albertdolata/Sensitive-Parameter-Recorder/PCB/SensorModule/SensorModule.kicad_pcb

## KiCad design PCB/SensorModule/SensorModule.kicad_pcb (2026-05-22)

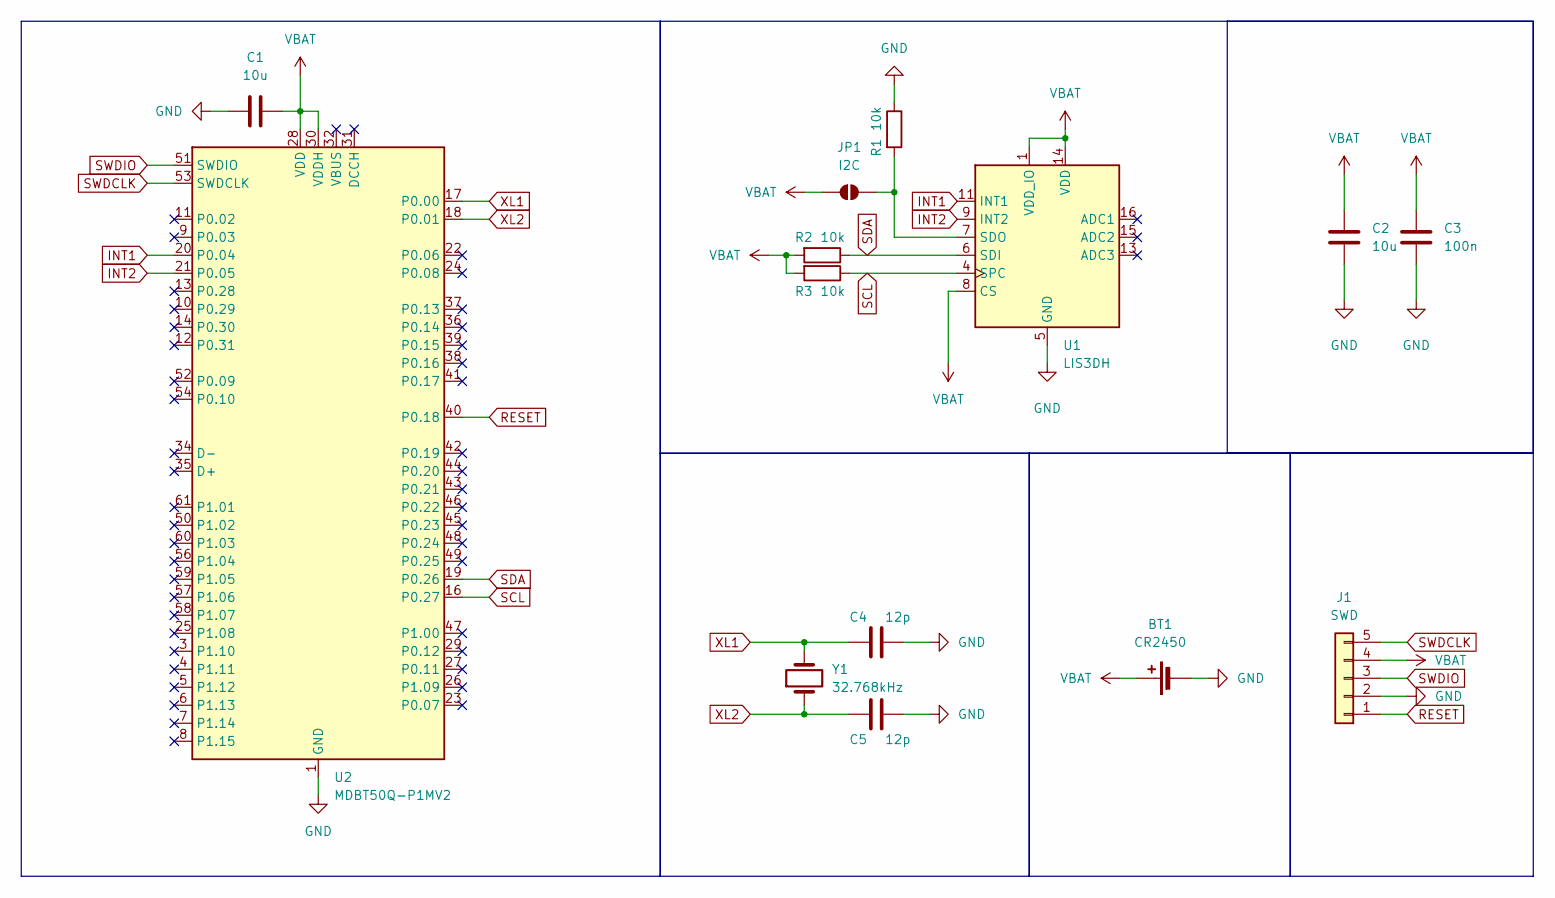
[picture p1: schematic SensorModule.kicad_sch, Sensor Module]

Parts:
BT1: CR2450; BatteryHolder_ComfortableElectronic_CH273-2450_1x2450
C1, C2: 10u; C_0402_1005Metric
C3: 100n; C_0402_1005Metric
C4, C5: 12p; C_0402_1005Metric
J1: SWD; PinHeader_1x05_P1.00mm_Vertical_SMD_Pin1Right
JP1: I2C; SolderJumper-2_P1.3mm_Open_TrianglePad1.0x1.5mm
R1, R2, R3: 10k; R_0402_1005Metric
U1: LIS3DH; LGA-16_3x3mm_P0.5mm_LayoutBorder3x5y
U2: MDBT50Q-P1MV2; Raytac_MDBT50Q
Y1: 32.768kHz; Crystal_SMD_3215-2Pin_3.2x1.5mm

Connections:
GND: BT1.2 (-), C1.1, C2.2, C3.2, C4.2, C5.2, J1.2, R1.1, U1.5 (GND), U1.10 (GND), U1.12 (GND), U2.1 (GND), U2.2 (GND), U2.15 (GND), U2.33 (GND), U2.55 (GND)
INT1: U1.11 (INT1), U2.20 (P0.04)
INT2: U1.9 (INT2), U2.21 (P0.05)
unnamed: JP1.1 (A), R1.2, U1.7 (SDO)
RESET: J1.1, U2.40 (P0.18)
SCL: R3.1, U1.4 (SPC), U2.16 (P0.27)
SDA: R2.1, U1.6 (SDI), U2.19 (P0.26)
SWDCLK: J1.5, U2.53 (SWDCLK)
SWDIO: J1.3, U2.51 (SWDIO)
VBAT: BT1.1 (+), C1.2, C2.1, C3.1, J1.4, JP1.2 (B), R2.2, R3.2, U1.1 (VDD_IO), U1.8 (CS), U1.14 (VDD), U2.28 (VDD), U2.30 (VDDH)
XL1: C4.1, U2.17 (P0.00), Y1.2
XL2: C5.1, U2.18 (P0.01), Y1.1

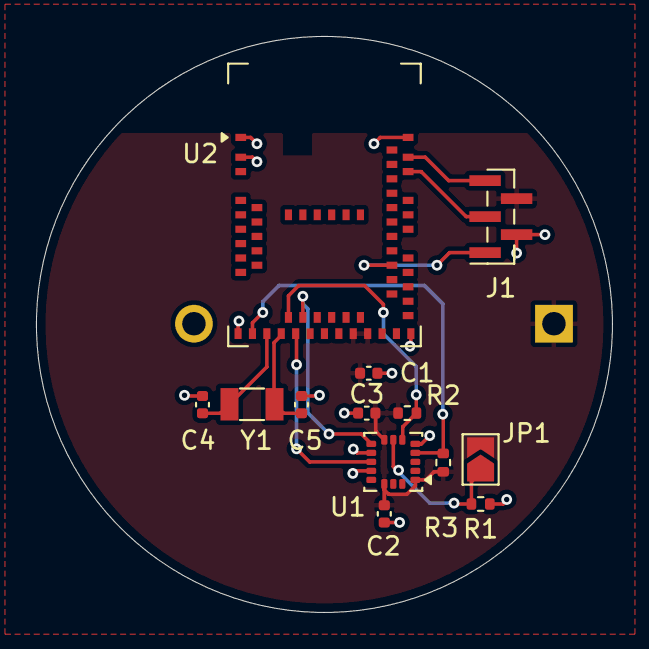
[picture p2: board SensorModule.kicad_pcb from above]

Board: 2 copper layers, 32.0 x 32.0 mm, 14 parts (1 on the bottom side), 12 nets.
