albertdolata/Sensitive-Parameter-Recorder/PCB/CentralUnit/CentralUnit.kicad_pcb

## KiCad design PCB/CentralUnit/CentralUnit.kicad_pcb (2026-05-22)

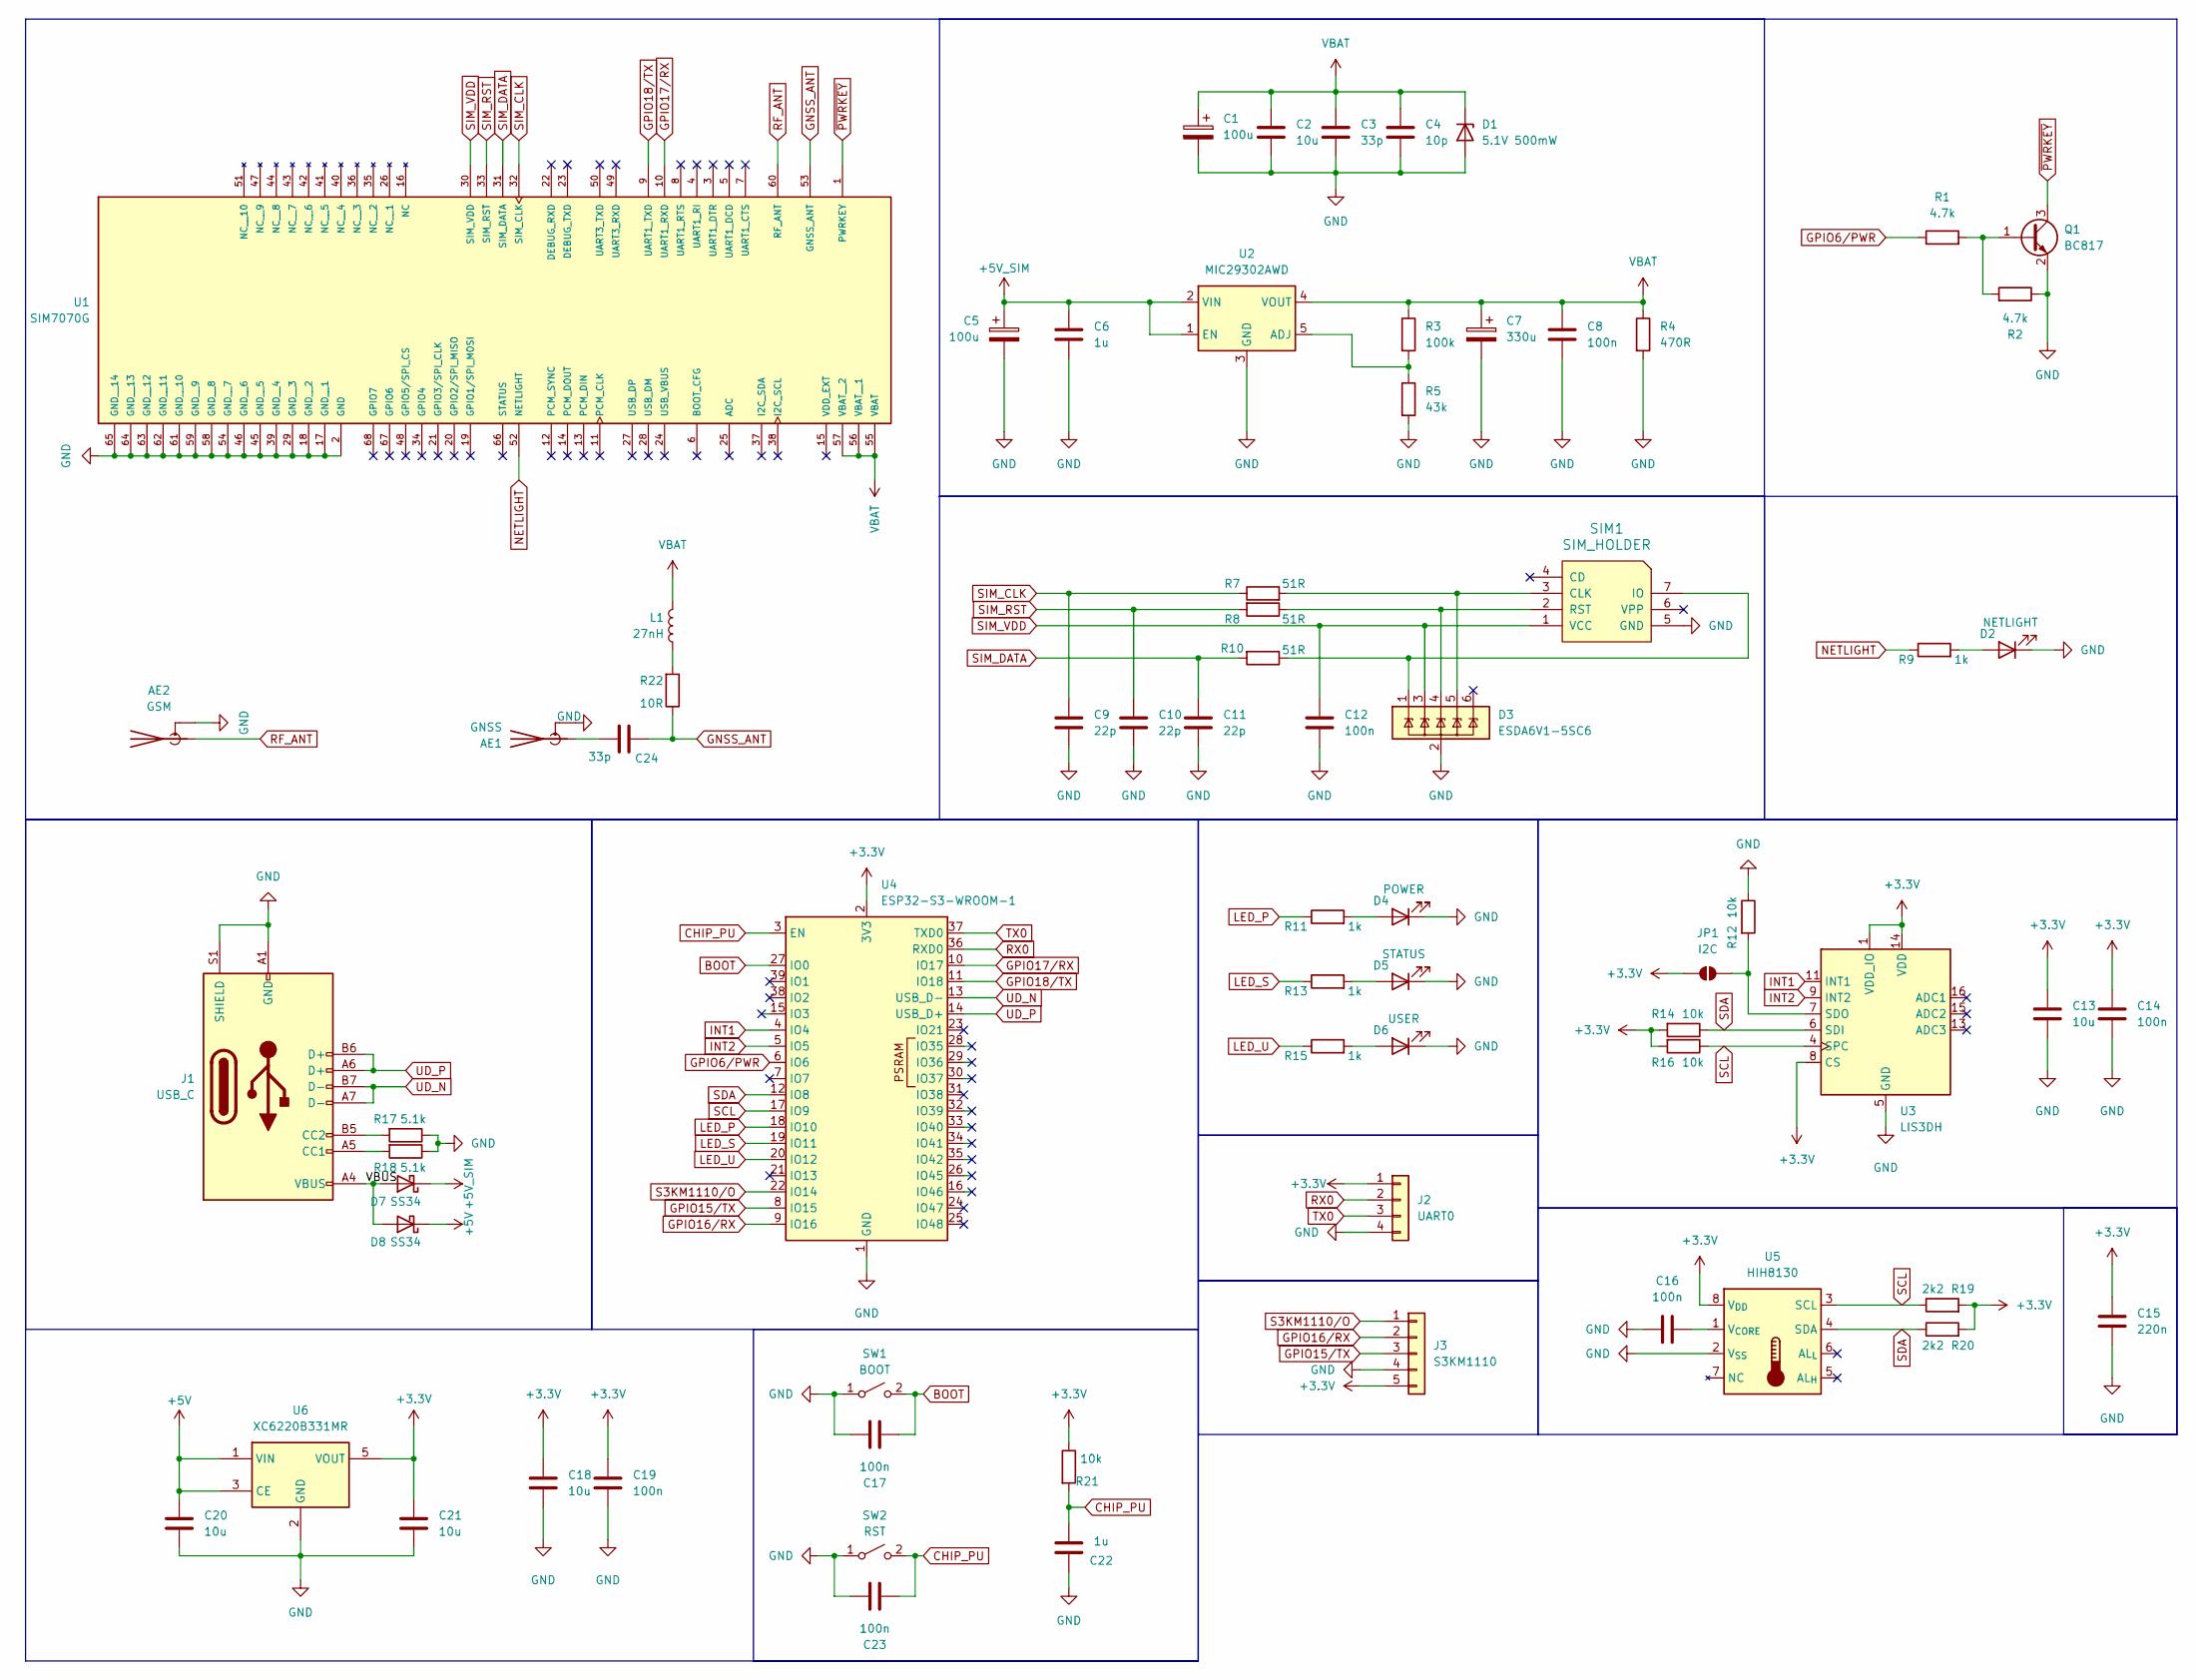
[picture p3: schematic CentralUnit.kicad_sch, Central Unit]

Parts:
AE1: GNSS; U.FL_Molex_MCRF_73412-0110_Vertical
AE2: GSM; U.FL_Molex_MCRF_73412-0110_Vertical
C1, C5: 100u; CP_EIA-3216-18_Kemet-A
C2, C13, C18, C20, C21: 10u; C_0402_1005Metric
C3, C24: 33p; C_0402_1005Metric
C4: 10p; C_0402_1005Metric
C6, C22: 1u; C_0402_1005Metric
C7: 330u; CP_EIA-6032-28_Kemet-C
C8, C12, C14, C16, C17, C19, C23: 100n; C_0402_1005Metric
C9, C10, C11: 22p; C_0402_1005Metric
C15: 220n; C_0402_1005Metric
D1: 5.1V 500mW; Nexperia_CFP3_SOD-123W
D2: NETLIGHT; LED_0805_2012Metric
D3: ESDA6V1-5SC6; SOT-23-6
D4: POWER; LED_0805_2012Metric
D5: STATUS; LED_0805_2012Metric
D6: USER; LED_0805_2012Metric
D7, D8: SS34; D_SMA
J1: USB_C; USB_C_Receptacle_HRO_TYPE-C-31-M-12
J2: UART0; PinHeader_1x04_P1.00mm_Vertical_SMD_Pin1Left
J3: S3KM1110; PinHeader_1x05_P2.54mm_Vertical
JP1: I2C; SolderJumper-2_P1.3mm_Open_TrianglePad1.0x1.5mm
L1: 27nH; L_0402_1005Metric
Q1: BC817; SOT-23
R1, R2: 4.7k; R_0402_1005Metric
R3: 100k; R_0402_1005Metric
R4: 470R; R_0402_1005Metric
R5: 43k; R_0402_1005Metric
R7, R8, R10: 51R; R_0402_1005Metric
R9, R11, R13, R15: 1k; R_0402_1005Metric; PART FIELD 1 ÌùÆ¬µç×è
R12, R14, R16, R21: 10k; R_0402_1005Metric
R17, R18: 5.1k; R_0402_1005Metric
R19, R20: 2k2; R_0402_1005Metric
R22: 10R; R_0402_1005Metric
SIM1: SIM_HOLDER; nanoSIM_SMN-303
SW1: BOOT; SW_Tactile_SPST_NO_Straight_CK_PTS636Sx25SMTRLFS
SW2: RST; SW_Tactile_SPST_NO_Straight_CK_PTS636Sx25SMTRLFS
U1: SIM7070G; SIM7070G_MODULE_SIM7070G; PARTREV V1.03
U2: MIC29302AWD; TO-252-5_1.27mm_TabPin3
U3: LIS3DH; LGA-16_3x3mm_P0.5mm_LayoutBorder3x5y
U4: ESP32-S3-WROOM-1
U5: HIH8130; SOIC-8_3.9x4.9mm_P1.27mm
U6: XC6220B331MR; SOT-23-5

Connections:
+3.3V: C13.1, C14.1, C15.1, C18.1, C19.1, C21.1, J2.1, J3.5, JP1.2 (B), R14.2, R16.2, R19.2, R20.2, R21.1, U3.1 (VDD_IO), U3.8 (CS), U3.14 (VDD), U4.2 (3V3), U5.8 (V_{DD}), U6.5 (VOUT)
+5V: C20.1, D8.1 (K), U6.1 (VIN), U6.3 (CE)
+5V_SIM: C5.1, C6.1, D7.1 (K), U2.1 (EN), U2.2 (VIN)
/VBUS: D7.2 (A), D8.2 (A), J1.A4 (VBUS), J1.A9 (VBUS), J1.B4 (VBUS), J1.B9 (VBUS)
BOOT: C17.2, SW1.2 (B), U4.27 (IO0)
CHIP_PU: C22.2, C23.2, R21.2, SW2.2 (B), U4.3 (EN)
GND: AE1.2 (Shield), AE2.2 (Shield), C1.2, C2.2, C3.2, C4.2, C5.2, C6.2, C7.2, C8.2, C9.2, C10.2, C11.2, C12.2, C13.2, C14.2, C15.2, C16.1, C17.1, C18.2, C19.2, C20.2, C21.2, C22.1, C23.1, D1.2 (A), D2.1 (K), D3.2 (GND), D4.1 (K), D5.1 (K), D6.1 (K), J1.A1 (GND), J1.A12 (GND), J1.B1 (GND), J1.B12 (GND), J1.S1 (SHIELD), J2.4, J3.4, Q1.2 (E), R2.1, R4.2, R5.2, R12.1, R17.1, R18.1, SIM1.5 (GND), SIM1.SH, SW1.1 (A), SW2.1 (A), U1.2 (GND), U1.17 (GND__1), U1.18 (GND__2), U1.29 (GND__3), U1.39 (GND__4), U1.45 (GND__5), U1.46 (GND__6), U1.54 (GND__7), U1.58 (GND__8), U1.59 (GND__9), U1.61 (GND__10), U1.62 (GND__11), U1.63 (GND__12), U1.64 (GND__13), U1.65 (GND__14), U2.3 (GND), U3.5 (GND), U3.10 (GND), U3.12 (GND), U4.1 (GND), U4.40 (GND), U4.41 (GND), U5.2 (V_{SS}), U6.2 (GND)
GNSS_ANT: C24.2, R22.1, U1.53 (GNSS_ANT)
GPIO6/PWR: R1.1, U4.6 (IO6)
GPIO15/TX: J3.3, U4.8 (IO15)
GPIO16/RX: J3.2, U4.9 (IO16)
GPIO17/RX: U1.10 (UART1_RXD), U4.10 (IO17)
GPIO18/TX: U1.9 (UART1_TXD), U4.11 (IO18)
INT1: U3.11 (INT1), U4.4 (IO4)
INT2: U3.9 (INT2), U4.5 (IO5)
LED_P: R11.1, U4.18 (IO10)
LED_S: R13.1, U4.19 (IO11)
LED_U: R15.1, U4.20 (IO12)
NETLIGHT: R9.1, U1.52 (NETLIGHT)
unnamed: AE1.1 (A), C24.1
unnamed: D2.2 (A), R9.2
unnamed: D3.1 (IO1), R10.1, SIM1.7 (IO)
unnamed: D3.4 (IO3), R8.1, SIM1.2 (RST)
unnamed: D3.5 (IO4), R7.2, SIM1.3 (CLK)
unnamed: D4.2 (A), R11.2
unnamed: D5.2 (A), R13.2
unnamed: D6.2 (A), R15.2
unnamed: J1.A5 (CC1), R18.2
unnamed: J1.B5 (CC2), R17.2
unnamed: JP1.1 (A), R12.2, U3.7 (SDO)
unnamed: L1.2, R22.2
unnamed: Q1.1 (B), R1.2, R2.2
unnamed: R3.2, R5.1, U2.5 (ADJ)
unnamed: C16.2, U5.1 (V_{CORE})
RF_ANT: AE2.1 (A), U1.60 (RF_ANT)
RX0: J2.2, U4.36 (RXD0)
S3KM1110/O: J3.1, U4.22 (IO14)
SCL: R16.1, R19.1, U3.4 (SPC), U4.17 (IO9), U5.3 (SCL)
SDA: R14.1, R20.1, U3.6 (SDI), U4.12 (IO8), U5.4 (SDA)
SIM_CLK: C9.1, R7.1, U1.32 (SIM_CLK)
SIM_DATA: C11.1, R10.2, U1.31 (SIM_DATA)
SIM_RST: C10.1, R8.2, U1.33 (SIM_RST)
SIM_VDD: C12.1, D3.3 (IO2), SIM1.1 (VCC), U1.30 (SIM_VDD)
TX0: J2.3, U4.37 (TXD0)
UD_N: J1.A7 (D-), J1.B7 (D-), U4.13 (USB_D-)
UD_P: J1.A6 (D+), J1.B6 (D+), U4.14 (USB_D+)
VBAT: C1.1, C2.1, C3.1, C4.1, C7.1, C8.1, D1.1 (K), L1.1, R3.1, R4.1, U1.55 (VBAT), U1.56 (VBAT__1), U1.57 (VBAT__2), U2.4 (VOUT)
~PWRKEY: Q1.3 (C), U1.1 (PWRKEY)

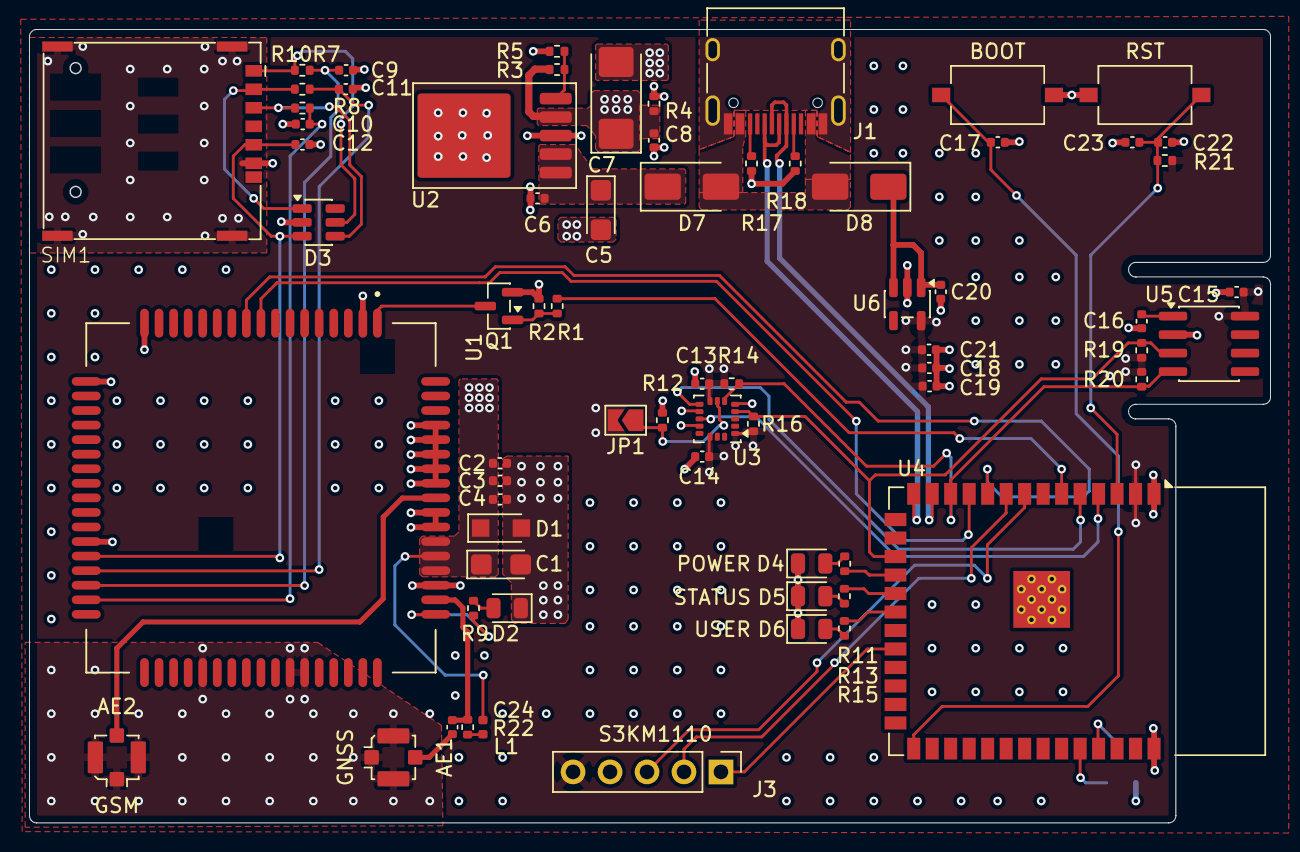
[picture p4: board CentralUnit.kicad_pcb from above]

Board: 4 copper layers, 85.2 x 54.5 mm, 70 parts (1 on the bottom side), 48 nets.
