albertdolata/Sensitive-Parameter-Recorder/(commit log)

2026-04-02 Refactor: add macro for number of sensors, add starting logs, fix delay logic
    [main.cpp]
2026-04-02 Upadte main fucntion, add contact and presence sensor object to the array of sensors
2026-04-02 Refactor class Sensor, add temporery fields for sensor values
2026-04-02 Refactor function readData in class TempHumSensor, store BME230 readings in shared Sensor values1-3
2026-04-02 Refactor classes AccelSensor, ContactSensor, PresennceSensor, now sotres it's reading in shared value Sensor value1
2026-04-12 Create Bluetooth Sensor Manager file
2026-04-12 Refactor: Class BLESensorManager now assings recived data to given sensor
2026-04-13 Update: class now is supporting 3 sensors
2026-04-13 Debug: add code for easier debugging while testing with real devices
2026-04-14 Update: extended fields in class Sensor for new data
2026-04-14 Update: deleted field shake - not usuable for prototape, updatethe assigning of values in switch section
2026-04-26 Variable edit: changed sensor fileds sent to ThingSpeak for debugging
2026-05-04 Add PCB KiCAD 9..0 Files
    [CentralUnit.kicad_pcb, CentralUnit.kicad_sch, SecCentralUnit.kicad_pcb, SecCentralUnit.kicad_sch, SensorModule.kicad_pcb, SensorModule.kicad_sch]
2026-05-10 pliki z konfiguracją esp32 i simcoma
    Pliki z konfiguracją esp32 i sim7000, funkcję pozwalające uruchomić sim'a, zalogować się do sieci, pobrać parametry stacji bazowej i wysłać przez mqtt. Do dodania, obsługa rzeczywistych sensorów i zbierania danych z nrf'a.
2026-05-22 expanded the fields of sensor_data_t structure for all sensors
2026-05-22 Commented flags out because by default without specifying bed parameters with zeros - an error
    [sim7000_core.cpp]
2026-05-29 Change Uart baud rate to fit my simcom in sim7000_core.cpp | fix assignment of current_data schock variable
    [main.cpp, sim7000_core.cpp]
2026-05-29 Add new field for time stamps of data in sensor_data_t
2026-05-29 Add ESP32 internal RTC synchronization with GPS
    - Add setESP32Time() to update internal timer when GPS has fix
    - Update current_data.timestamp to source time from ESP32 RTC
    [main.cpp]
2026-05-29 Refactor: extract data assignment of sensor_data_t to assignDataToStruct function
2026-05-29 Refactor: extract sensor table initialization logic to SensorTableInit function
2026-05-29 Refactor: extract readData from sensor logic to readDataFromSensor function
2026-05-29 Fix bugs after testing offline data storing
    - Timestamp is now correctly saved in offline data
    - Fixed looping problem with data recovery from internal flash memory
    [main.cpp]
2026-06-12 Refacotr: update class for TH06 sensor
2026-06-12 Refacotr: update class for LIS3DH accelerometer
2026-06-13 Create new class for BLE pallet sensor
2026-06-15 Upadte: add proper fields in struct for sensor data
2026-06-16 Fix: resolve switch case compile error in BLESensorManager
2026-06-16 Fix: update JSON generator with correct fields and data types
    [data_send_service.cpp]
2026-06-16 Update: add proper fields to struct for accelerometer data
2026-06-16 Add usage of LEDs on board
2026-06-16 Update rx/tx pin for hardware
2026-06-18 Update: Integrate GPSManager with SIM7070E
    - Add pause/resume functions to control GPS power
    - Fix include path
2026-06-18 Fix typos to match proper sim7070 functions
    [data_send_service.cpp]
2026-06-18 Fix: Increase stack size for data_sender_task to 8KB
    - Resolves Guru Meditation Error (Stack Overflow) when processing massive offline data backlog from SPIFFS
    [data_send_service.cpp]
2026-06-18 Refactor: Update main.cpp for SIM7070E and prepare for hardware tests
    - Rename all sim7000_* function calls to sim7070_* to match the new core
    - Enable global INFO logs and set SIM7070_GPRS to DEBUG level
    - Temporarily comment out GPS routines pending hardware rework
    [main.cpp]
2026-06-23 Refactor: switch to MAC address filtering and remoce second pallet sensor
2026-06-23 Fix: implement MQTT disconnect to prevent RF transceiver crash Resolved hardware-level conflicts in the SIM7070E modem caused by simultaneous RF demands from active PDP/MQTT contexts and GNSS wake-up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
    sim7070_core.h & sim_mod.c:
    - Added sim7070_mqtt_disconnect() to safely terminate MQTT sessions (AT+SMDISC) and deactivate the PDP context (AT+CNACT=0,0).
    - Refactored the IP allocation active polling loop (Active Polling) to improve connection stability and prevent T-Mobile network rejections.
    data_send_service.h & data_send_service.cpp:
    - Updated the data_sender_task to monitor queue size via uxQueueMessagesWaiting().
    - The background task now explicitly closes all network connections when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
    [data_send_service.cpp]
2026-06-23 Refactor: add MAC addresses and implement initial GPS fix waiting
    [main.cpp]
2026-06-25 refactor: restructure offline storage and prevent FSM deadlocks
    - Relocate SPIFFS backup logic to data_send_service to decouple it from main state machine.
    - Reduce data_queue size to 1 and trigger automatic SPIFFS save on RAM full.
    - Remove blocking vTaskDelay in data_sender_task to prevent GSM/GNSS RF collisions.
    - Increase JSON buffer to 768 bytes and add motion_detected_p1 (p1mot) to payload.
    - Optimize sendBackupData to bypass RAM queue, reducing Flash memory wear.
    [data_send_service.cpp]
2026-06-25 Fix: decouple power state from fix status and resolve state machine bugs
    - Introduce 'fixStatus' to track satellite fix independently from module power state ('isON').
    - Add 'isPowered()' getter to safely expose hardware state to the main state machine.
    - Fix inverted guard clause in 'resume()' and ensure 'fixStatus' and timestamps are cleared on wake.
    - Add guard clause in 'update()' to prevent polling the GNSS baseband when powered off.
    - Remove raw NMEA serial debug prints to reduce log clutter.
2026-06-26 Refactor: implement non-blocking FSM and decouple core services
    - Replace linear, delay-based main loop with a non-blocking Finite State Machine (FSM).
    - Delegate all SPIFFS offline backup logic entirely to 'data_send_service'.
    - Offload BLE scanning to a dedicated FreeRTOS background task ('bleScanTask') pinned to Core 0.
    - Add 120-second timeout for GNSS fix acquisition in State 0 to prevent FSM stalling.
    - Implement Anti-Spoofing logic (FSM State 1) to fetch BTS cell info with a 15-second timeout.
    - Safely multiplex GNSS and GSM radio usage by pausing/resuming GPS based on FSM states.
    - Remove redundant blocking loops to ensure predictable main loop execution.
    [main.cpp]
2026-06-26 Refactor: remove serial prints and restrict global debug levels to errors
    [data_send_service.cpp, main.cpp]
2026-06-28 Update/Fix: LED STATUS blinks when got package form ble devices, LED USER lights up while system in sending data state, fixed backup data storage system,
    [data_send_service.cpp, main.cpp]
2026-06-28 Fix: resolve bootloop, fix CREG/CGREG network check, and implement self-recovery mechanism
    [sim7070_core.c]
2026-06-29 Update/Fix: implement fault-tolerance and SPIFFS protection
    Modem & Network Recovery:
    - Add hardware-level modem recovery after 3 consecutive connection failures.
    - Fix IP zombie state: shift failure counter reset to End-to-End ACK (MQTT success) rather than just CREG/CGREG attach.
    - Implement global watchdog in main loop to trigger ESP.restart() if the sending cycle exceeds 3 minutes.
    SPIFFS Protection & Data Integrity:
    - Secure file operations with FreeRTOS Mutex to prevent read/write/delete race conditions.
    - Implement backlog capacity limit (45000 records) with automatic trimming (drop oldest 10%) to prevent flash overflow.
    - Add write-verification and self-healing logic to detect byte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
    [data_send_service.cpp, main.cpp, sim7070_core.c]
2026-06-29 Build: unlock full 8MB flash and expand SPIFFS partition
    Added custom partitions.csv to utilize the full 8MB hardware flash of the ESP32-S3. Reallocated space to provide ~5MB for the SPIFFS data partition, significantly increasing offline backlog capacity.
    [partitions.csv]
2026-08-05 Add doxygen comments to the Sensor class file
2026-08-08 Update: ESP time is now updating every 1 hour (if gps has fix) instead of every time when gps has fix
    [main.cpp]
2026-08-08 Fix: GPS_valid flag is correctly set, GPSManager variables are now correctyl initialized in constructor
    [data_send_service.cpp]
2026-08-08 Changed serwer connection to deafule MQTT broker
    [sim7070_core.c]
